gratian/hobby/kicad/bbb_alien_harness/bbb_alien_harness.kicad_pcb

## KiCad design kicad/bbb_alien_harness/bbb_alien_harness.kicad_pcb (2019-04-03)

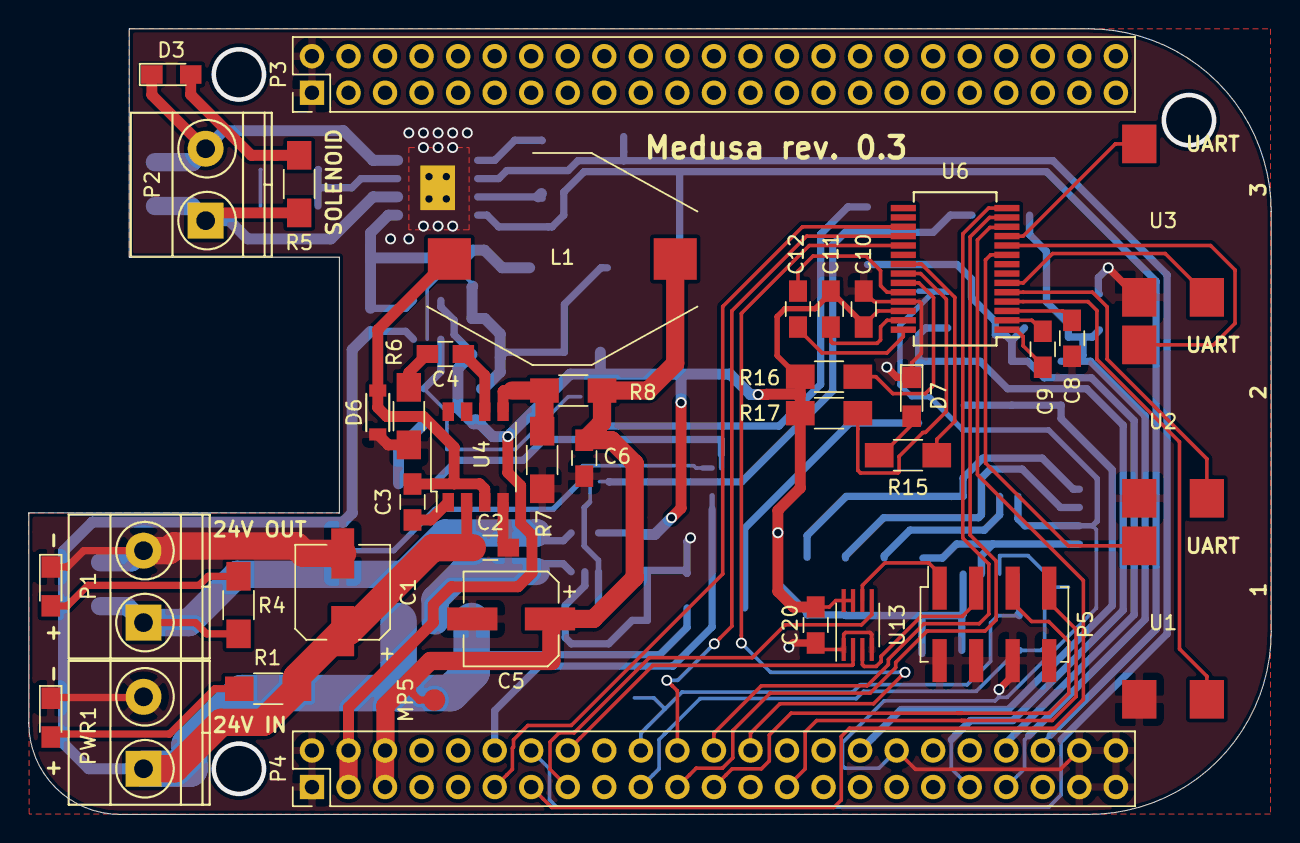
[picture p1: board bbb_alien_harness.kicad_pcb from above]

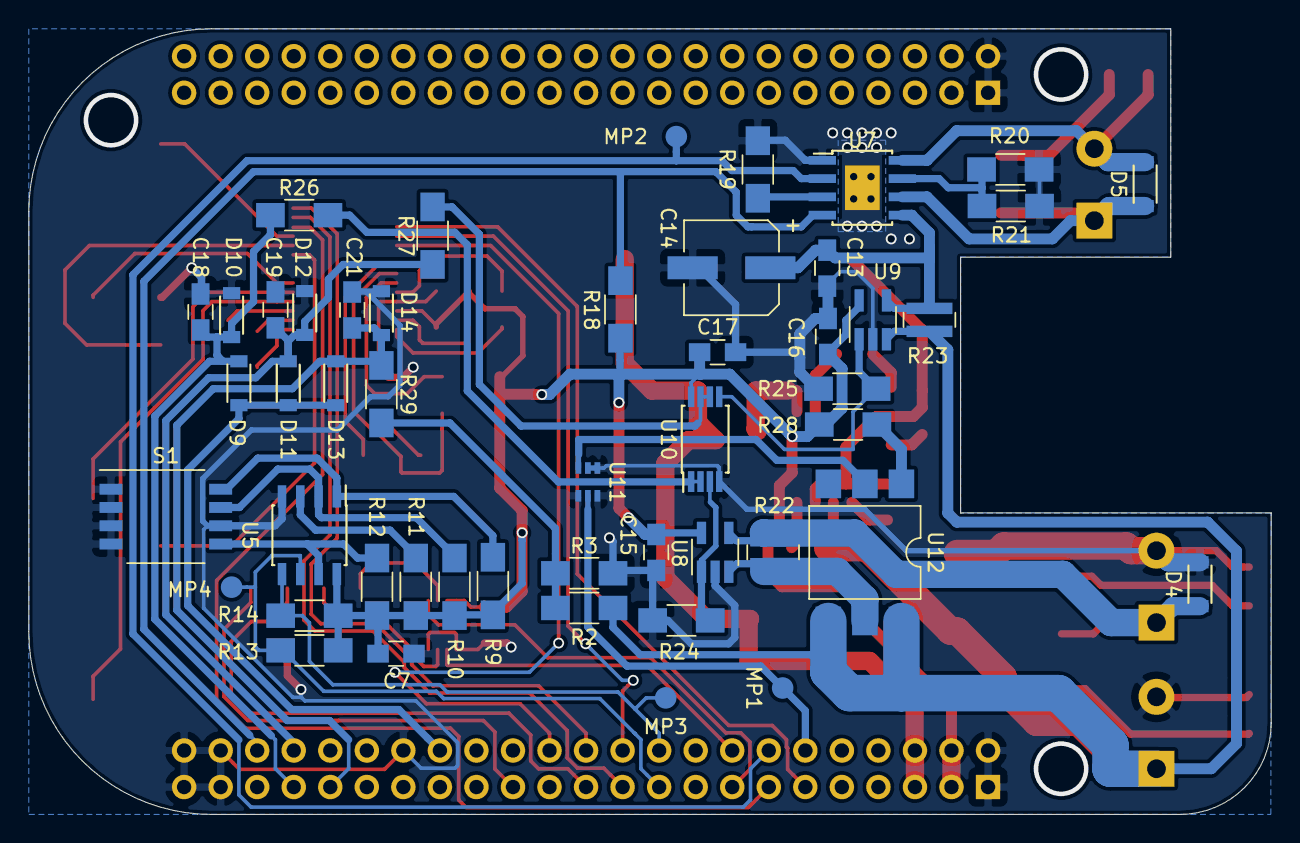
[picture p2: board bbb_alien_harness.kicad_pcb from below]

Board: 2 copper layers, 86.4 x 54.6 mm, 89 parts (49 on the bottom side), 67 nets.

Parts:
C1, C14: 47uF; CP_Elec_6.3x5.8
C2: 10uF; C_0805_HandSoldering
C3: 10nF; C_0805_HandSoldering
C4: 2.2nF; C_0805_HandSoldering
C5: 100uF; CP_Elec_6.3x5.8
C6: 1uF; C_0805_HandSoldering
C7, C8, C9, C10, C11, C12, C13, C15, C16, C17, C20: 0.1uF; C_0805_HandSoldering
C18, C19, C21: 1nF; C_0805_HandSoldering
D1: LXT0805YW; LED_0805_HandSoldering
D2, D7: LXT0805GW; LED_0805_HandSoldering
D3: D_1112H; LED_0805_HandSoldering
D4, D5, D6, D9, D10, D11, D12, D13, D14: DB2W40300L; SMD-Mini2-F3-B
L1: 33uH; L_Bourns-PM5022-330M-RC
MP1: SSR EN; Measurement_Point_Round-SMD-Pad_Small
MP2: PWM; Measurement_Point_Round-SMD-Pad_Small
MP3: I2C SDA; Measurement_Point_Round-SMD-Pad_Small
MP4: I2C SCL; Measurement_Point_Round-SMD-Pad_Small
MP5: +5V; Measurement_Point_Round-SMD-Pad_Small
P1: 24V OUT; TerminalBlock_Phoenix_MKDS1.5-2pol
P2: SOLENOID; TerminalBlock_Phoenix_MKDS1.5-2pol
P3: P8 on BBB; Pin_Header_Straight_2x23_Pitch2.54mm
P4: P9 on BBB; Pin_Header_Straight_2x23_Pitch2.54mm
P5: CONN_02X04; Socket_Strip_Straight_2x04_Pitch2.54mm_SMD
PWR1: 24V IN; TerminalBlock_Phoenix_MKDS1.5-2pol
R1, R4, R5: 2.4k; R_1206_HandSoldering
R2: 150k; R_1206_HandSoldering
R3, R7, R12, R16, R17, R18: 10k; R_1206_HandSoldering
R6: 8.2k; R_1206_HandSoldering
R8: 52k; R_1206_HandSoldering
R9, R10, R11: 4.7k; R_1206_HandSoldering
R13, R14: 5.6k; R_1206_HandSoldering
R15: 1k; R_1206_HandSoldering
R19: 100k; R_1206_HandSoldering
R20: 1; R_1206_HandSoldering
R21: 2; R_1206_HandSoldering
R22, R23: 0.020; R_0612
R24, R25: 75k; R_1206_HandSoldering
R26, R27, R29: 75; R_1206_HandSoldering
R28: 360; R_1206_HandSoldering
S1: SW_DIP_x4; SW_DIP_x4_W7.62mm_Slide_Copal_CHS-B
U1, U2, U3: SERIAL; SJ1-251X-SMT 2.5mm stereo jack
U4: ACT4065A; SOP-8_4.4x5mm_Pitch1.27mm
U5: 24C256; SOIC-8_3.9x4.9mm_Pitch1.27mm
U6: MAX3243; SSOP-28_5.3x10.2mm_Pitch0.65mm
U7: DRV8872; TI_SO-PowerPAD-8
U8, U9: INA138; SOT-23-5_HandSoldering
U10: AD8542; TSSOP-8_4.4x3mm_Pitch0.65mm
U11: DMC56404; SMini6-F3-B
U12: AQV251A; SMDIP-6_W9.53mm
U13: SN74LVC2G241; SSOP-8_2.95x2.8mm_Pitch0.65mm

Connections:
5V_REG: C5.1, C6.1, L1.2, MP5.1, P4.5, P4.6, R8.1
+3V3: C7.1, C10.2, C11.2, C15.1, C16.1, C17.1, C20.1, P4.3, P4.4, R9.1, R10.1, R11.1, R12.1, R13.1, R14.1, R16.1, R17.1, R18.1, R28.2, U5.8, U6.26, U8.5, U9.5, U10.8, U13.7, U13.8
+24V: C1.1, C2.1, PWR1.1, R1.1, R2.1, R23.1, U4.2, U9.3, U12.4, U12.6
/24V SSR/24V_OUT: R22.2, U8.3, U12.5
/POWER SENSE/OUT1: D4.1, P1.1, R4.1, R22.1, U8.4
/POWER SENSE/OUT2: C13.1, C14.1, R23.2, U7.5, U9.4
/POWER SENSE/sheet5AE7F055/IN: R26.2, U10.1, U10.2
/POWER SENSE/sheet5AE871AC/IN: R27.2, U10.6, U10.7
/SERIAL/RS232_RX1: U1.1, U6.4
/SERIAL/RS232_RX2: U2.1, U6.5
/SERIAL/RS232_RX3: U3.1, U6.6
/SERIAL/RS232_TX1: U1.2, U6.9
/SERIAL/RS232_TX2: U2.2, U6.10
/SERIAL/RS232_TX3: U3.2, U6.11
/SOLENOID DRIVER/S+: D5.1, P2.1, R5.1, U7.6
/SOLENOID DRIVER/S-: D3.1, D5.2, P2.2, U7.8
/sheet5B1360C9/IN: R2.2, R3.1, R29.2
AIN0: C18.1, D9.2, D10.1, P4.39, R26.1
AIN1: C19.1, D11.2, D12.1, P4.40, R27.1
AIN2: C21.1, D13.2, D14.1, P4.37, R29.1
EHRPWM1A: MP2.1, P4.14, U7.2
EHRPWM1B: P4.16, U13.2
GND: C1.2, C2.2, C5.2, C6.2, C7.2, C8.1, C10.1, C13.2, C14.2, C15.2, C16.2, C17.2, C18.2, C19.2, C20.2, C21.2, D1.1, D2.1, D4.2, D6.2, D7.1, D10.2, D12.2, D14.2, P1.2, P3.1, P3.2, P4.1, P4.2, P4.34, P4.43, P4.44, P4.45, P4.46, P5.2, P5.4, P5.6, P5.8, PWR1.2, R3.2, R6.2, R7.2, R19.2, R20.1, R21.1, R24.2, R25.2, S1.1, S1.2, S1.3, S1.4, S1.6, U1.3, U2.3, U3.3, U4.4, U5.4, U6.25, U7.1, U7.9, U8.2, U9.2, U10.4, U11.1, U11.3, U11.4, U11.5, U13.1, U13.4
GPIO0_7&GPIO3_18: P4.42, R18.2, U7.4
GPIO1_16: P4.15, U13.5
GPIO1_17: P4.23, P5.5
GPIO1_28: MP1.1, P4.12, U11.2
GPIO3_19: P4.27, P5.7
I2C2_SCL: MP4.1, P4.19, R13.2, U5.6
I2C2_SDA: MP3.1, P4.20, R14.2, U5.5
unnamed: C3.1, U4.1
unnamed: C3.2, D6.1, L1.1, U4.3
unnamed: C4.1, U4.6
unnamed: C4.2, R6.1
unnamed: C8.2, U6.3
unnamed: C9.1, U6.1
unnamed: C9.2, U6.2
unnamed: C11.1, U6.27
unnamed: C12.1, U6.28
unnamed: C12.2, U6.24
unnamed: D1.2, R1.2
unnamed: D2.2, R4.2
unnamed: D3.2, R5.2
unnamed: D7.2, R15.1
unnamed: P5.1, U13.6
unnamed: P5.3, U13.3
unnamed: R7.1, R8.2, U4.5
unnamed: R9.2, S1.8, U5.1
unnamed: R10.2, S1.7, U5.2
unnamed: R11.2, U5.3
unnamed: R12.2, S1.5, U5.7
unnamed: R15.2, U6.21
unnamed: R16.2, U6.23
unnamed: R17.2, U6.22
unnamed: R19.1, U7.3
unnamed: R20.2, R21.2, U7.7
unnamed: R24.1, U8.1, U10.3
unnamed: R25.1, U9.1, U10.5
unnamed: R28.1, U12.1
unnamed: U11.6, U12.2
UART1_RXD: P4.26, U6.19
UART1_TXD: P4.24, U6.14
UART2_RXD: P4.22, U6.18
UART2_TXD: P4.21, U6.13
UART4_RXD: P4.11, U6.17
UART4_TXD: P4.13, U6.12
VADC: D9.1, D11.1, D13.1, P4.32
