gratian/hobby/kicad/stepper_driver_with_protection/stepper_driver.kicad_pcb

## KiCad design kicad/stepper_driver_with_protection/stepper_driver.kicad_pcb (2018-04-12)

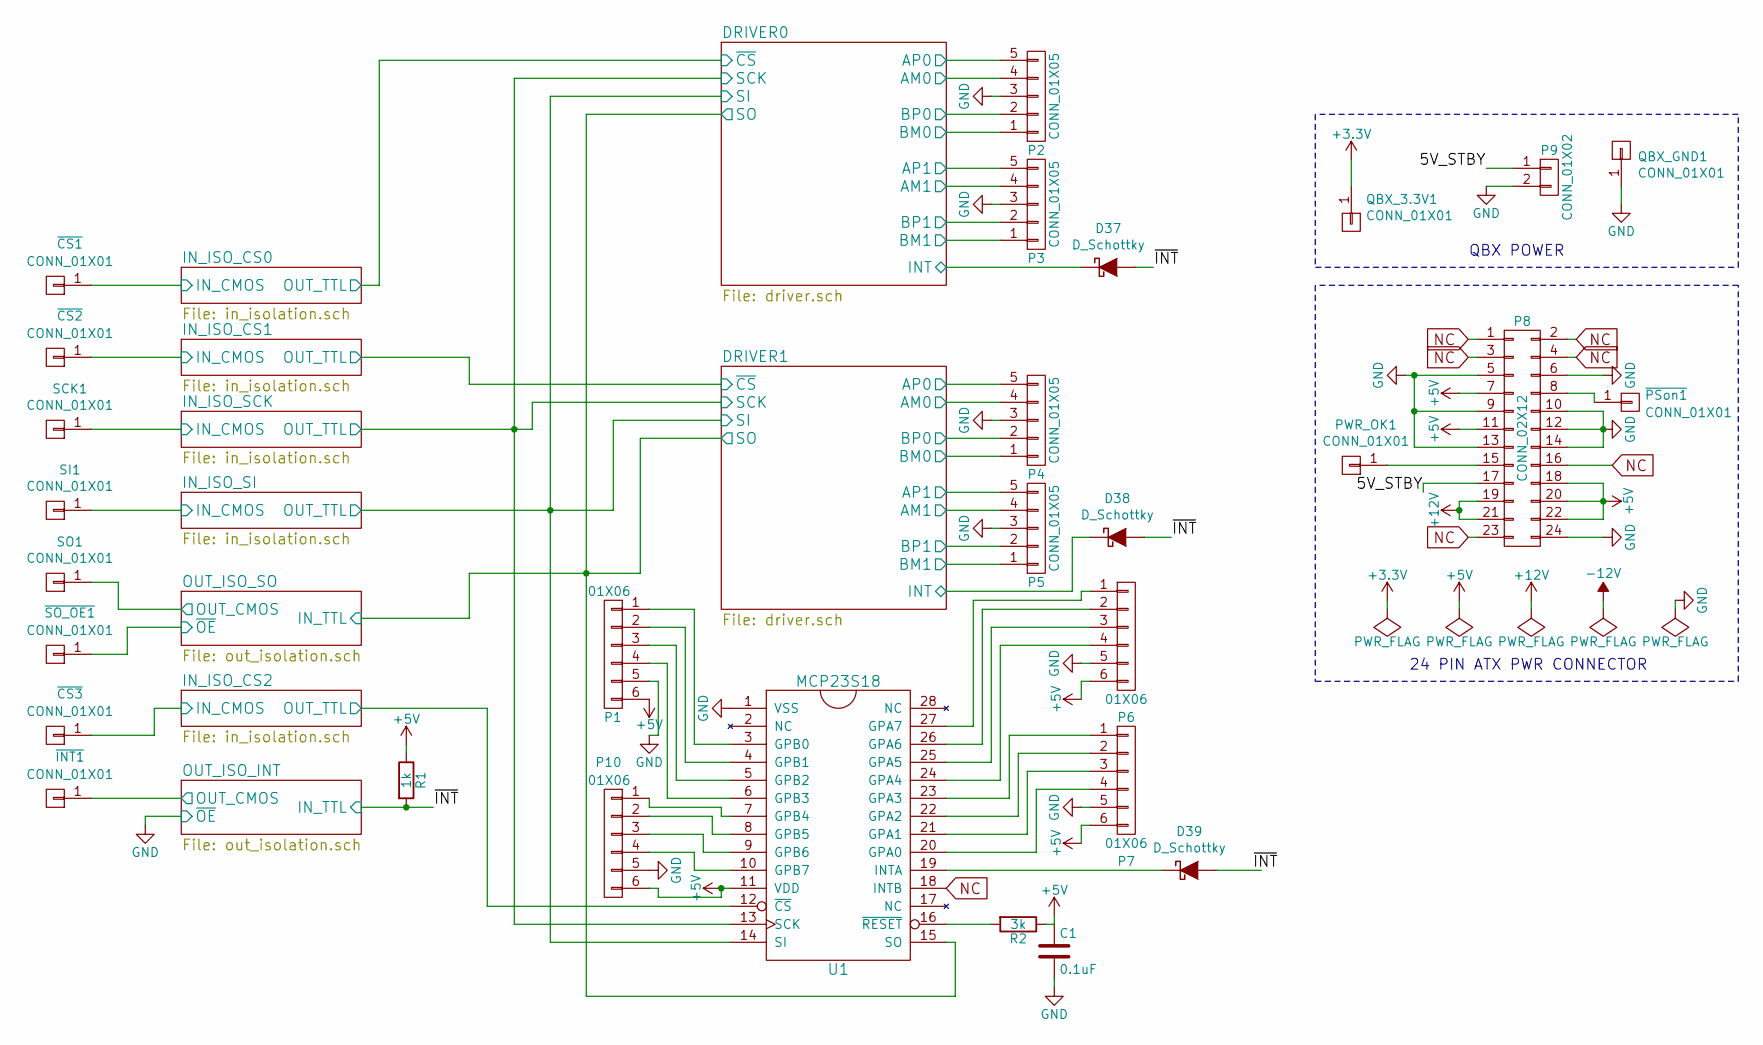
[picture p3: schematic stepper_driver.sch, Quad Stepper Motor Driver]

Parts:
C1: 0.1uF; C_1206_HandSoldering
D37, D38, D39: D_Schottky; Diode_DO-41_SOD81_Horizontal_RM10
P1, P6, P7, P10: 01X06; KF2EDGK-6_pin_Screw_Terminal_Block
P2, P3, P4, P5: CONN_01X05; TerminalBlock_Pheonix_PT-3.5mm_5pol
P8: CONN_02X12; Molex_MiniFit-JR-5556-24A_2x12x4.20mm_Straight
P9: CONN_01X02; PINHEAD1-2
PWR_OK1: CONN_01X01; SolderWirePad_single_0-8mmDrill
QBX_3.3V1: CONN_01X01; SolderWirePad_single_0-8mmDrill
QBX_GND1: CONN_01X01; SolderWirePad_single_0-8mmDrill
R1: 1k; R_1206_HandSoldering
R2: 3k; R_1206_HandSoldering
SCK1: CONN_01X01; SolderWirePad_single_0-8mmDrill
SI1: CONN_01X01; SolderWirePad_single_0-8mmDrill
SO1: CONN_01X01; SolderWirePad_single_0-8mmDrill
U1: MCP23S18; SOIC-28
~CS1, ~CS2, ~CS3: CONN_01X01; SolderWirePad_single_0-8mmDrill
~INT1: CONN_01X01; SolderWirePad_single_0-8mmDrill
~PSon1: CONN_01X01; SolderWirePad_single_0-8mmDrill
~SO_OE1: CONN_01X01; SolderWirePad_single_0-8mmDrill

Connections:
+3V3: QBX_3.3V1.1; also elsewhere on the board
+5V: C1.1, P1.6, P6.6, P7.6, P8.7, P8.11, P8.18, P8.20, P8.22, P10.6, R1.1, R2.1, U1.11 (VDD); also elsewhere on the board
+12V: P8.19, P8.21; also elsewhere on the board
/5V_STBY: P8.17, P9.1
/DRIVER0/AM0: P2.4; also elsewhere on the board
/DRIVER0/AM1: P3.4; also elsewhere on the board
/DRIVER0/AP0: P2.5; also elsewhere on the board
/DRIVER0/AP1: P3.5; also elsewhere on the board
/DRIVER0/BM0: P2.1; also elsewhere on the board
/DRIVER0/BM1: P3.1; also elsewhere on the board
/DRIVER0/BP0: P2.2; also elsewhere on the board
/DRIVER0/BP1: P3.2; also elsewhere on the board
/DRIVER0/INT: D37.1 (K); also elsewhere on the board
/DRIVER1/AM0: P4.4; also elsewhere on the board
/DRIVER1/AM1: P5.4; also elsewhere on the board
/DRIVER1/AP0: P4.5; also elsewhere on the board
/DRIVER1/AP1: P5.5; also elsewhere on the board
/DRIVER1/BM0: P4.1; also elsewhere on the board
/DRIVER1/BM1: P5.1; also elsewhere on the board
/DRIVER1/BP0: P4.2; also elsewhere on the board
/DRIVER1/BP1: P5.2; also elsewhere on the board
/DRIVER1/INT: D38.1 (K); also elsewhere on the board
/IN_ISO_CS2/OUT_TTL: U1.12 (~CS); also elsewhere on the board
/IN_ISO_SCK/IN_CMOS: SCK1.1; also elsewhere on the board
/IN_ISO_SCK/OUT_TTL: U1.13 (SCK); also elsewhere on the board
/IN_ISO_SI/IN_CMOS: SI1.1; also elsewhere on the board
/IN_ISO_SI/OUT_TTL: U1.14 (SI); also elsewhere on the board
/OUT_ISO_SO/IN_TTL: U1.15 (SO); also elsewhere on the board
/OUT_ISO_SO/OUT_CMOS: SO1.1; also elsewhere on the board
/~INT: D37.2 (A), D38.2 (A), D39.2 (A), R1.2; also elsewhere on the board
GND: C1.2, P1.5, P2.3, P3.3, P4.3, P5.3, P6.5, P7.5, P8.5, P8.6, P8.9, P8.10, P8.12, P8.13, P8.14, P8.24, P9.2, P10.5, QBX_GND1.1, U1.1 (VSS); also elsewhere on the board
NC: P8.1, P8.2, P8.3, P8.4, P8.16, P8.23, U1.18 (INTB); also elsewhere on the board
unnamed: D39.1 (K), U1.19 (INTA)
unnamed: P1.1, U1.3 (GPB0)
unnamed: P1.2, U1.4 (GPB1)
unnamed: P1.3, U1.5 (GPB2)
unnamed: P1.4, U1.6 (GPB3)
unnamed: P6.1, U1.27 (GPA7)
unnamed: P6.2, U1.26 (GPA6)
unnamed: P6.3, U1.25 (GPA5)
unnamed: P6.4, U1.24 (GPA4)
unnamed: P7.1, U1.23 (GPA3)
unnamed: P7.2, U1.22 (GPA2)
unnamed: P7.3, U1.21 (GPA1)
unnamed: P7.4, U1.20 (GPA0)
unnamed: P8.8, ~PSon1.1
unnamed: P8.15, PWR_OK1.1
unnamed: P10.1, U1.7 (GPB4)
unnamed: P10.2, U1.8 (GPB5)
unnamed: P10.3, U1.9 (GPB6)
unnamed: P10.4, U1.10 (GPB7)
unnamed: R2.2, U1.16 (~RESET)

Notes on the sheet:
24 PIN ATX PWR CONNECTOR
QBX POWER

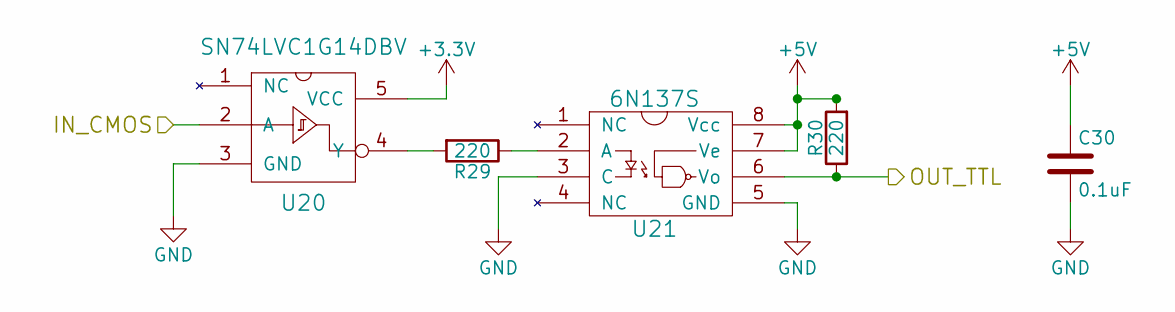
[picture p4: schematic in_isolation.sch, Quad Stepper Motor Driver]

Parts:
C2: 0.1uF; C_1206_HandSoldering
R3, R4: 220; R_1206_HandSoldering
U2: SN74LVC1G14DBV; SOT-23-5
U3: 6N137S; SMD-8

Connections:
+3V3: U2.5 (VCC); also elsewhere on the board
+5V: C2.1, R4.2, U3.7 (Ve), U3.8 (Vcc); also elsewhere on the board
/IN_ISO_CS0/IN_CMOS: U2.2 (A)
/IN_ISO_CS0/OUT_TTL: R4.1, U3.6 (Vo); also elsewhere on the board
GND: C2.2, U2.3 (GND), U3.3 (C), U3.5 (GND); also elsewhere on the board
unnamed: R3.1, U3.2 (A)
unnamed: R3.2, U2.4 (Y)

Parts of its further copies:
C3, C5, C6, C30: 0.1uF; C_1206_HandSoldering
R5, R6, R9, R10, R11, R12, R29, R30: 220; R_1206_HandSoldering
U4, U8, U10, U20: SN74LVC1G14DBV; SOT-23-5
U5, U9, U11, U21: 6N137S; SMD-8

Connections of its further copies:
+3V3: U4.5 (VCC), U8.5 (VCC), U10.5 (VCC), U20.5 (VCC); also elsewhere on the board
+5V: C3.1, C5.1, C6.1, C30.1, R6.2, R10.2, R12.2, R30.2, U5.7 (Ve), U5.8 (Vcc), U9.7 (Ve), U9.8 (Vcc), U11.7 (Ve), U11.8 (Vcc), U21.7 (Ve), U21.8 (Vcc); also elsewhere on the board
/IN_ISO_CS1/IN_CMOS: U10.2 (A)
/IN_ISO_CS1/OUT_TTL: R12.1, U11.6 (Vo); also elsewhere on the board
/IN_ISO_CS2/IN_CMOS: U20.2 (A)
/IN_ISO_CS2/OUT_TTL: R30.1, U21.6 (Vo); also elsewhere on the board
/IN_ISO_SCK/IN_CMOS: U4.2 (A); also elsewhere on the board
/IN_ISO_SCK/OUT_TTL: R6.1, U5.6 (Vo); also elsewhere on the board
/IN_ISO_SI/IN_CMOS: U8.2 (A); also elsewhere on the board
/IN_ISO_SI/OUT_TTL: R10.1, U9.6 (Vo); also elsewhere on the board
GND: C3.2, C5.2, C6.2, C30.2, U4.3 (GND), U5.3 (C), U5.5 (GND), U8.3 (GND), U9.3 (C), U9.5 (GND), U10.3 (GND), U11.3 (C), U11.5 (GND), U20.3 (GND), U21.3 (C), U21.5 (GND); also elsewhere on the board
unnamed: R5.1, U5.2 (A)
unnamed: R5.2, U4.4 (Y)
unnamed: R9.1, U9.2 (A)
unnamed: R9.2, U8.4 (Y)
unnamed: R11.1, U11.2 (A)
unnamed: R11.2, U10.4 (Y)
unnamed: R29.1, U21.2 (A)
unnamed: R29.2, U20.4 (Y)

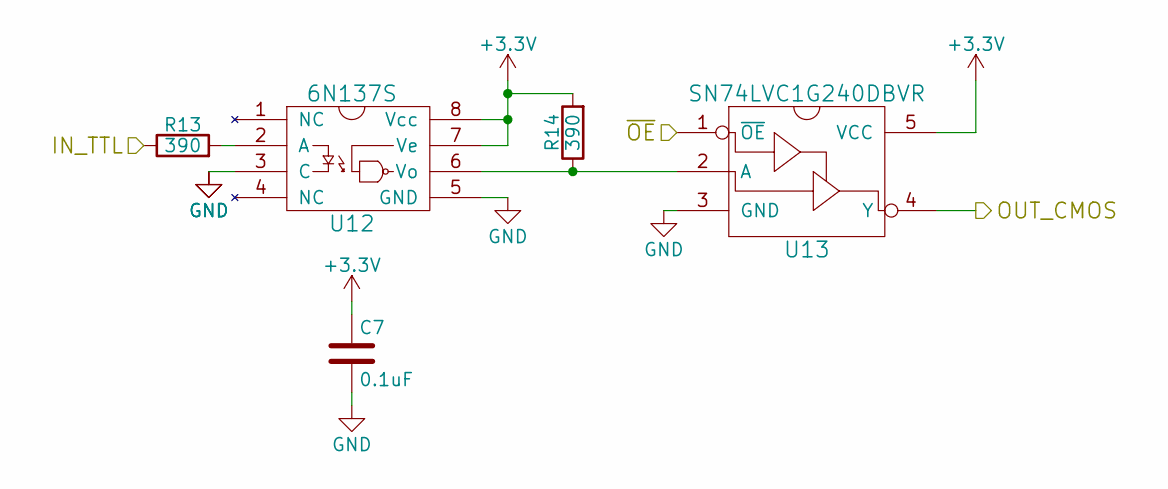
[picture p5: schematic out_isolation.sch, Quad Stepper Motor Driver]

Parts:
C4: 0.1uF; C_1206_HandSoldering
R7, R8: 390; R_1206_HandSoldering
U6: 6N137S; SMD-8
U7: SN74LVC1G240DBVR; SOT-23-5

Connections:
+3V3: C4.1, R8.2, U6.7 (Ve), U6.8 (Vcc), U7.5 (VCC); also elsewhere on the board
/OUT_ISO_SO/IN_TTL: R7.1; also elsewhere on the board
/OUT_ISO_SO/OUT_CMOS: U7.4 (Y); also elsewhere on the board
/OUT_ISO_SO/~OE: U7.1 (~OE)
GND: C4.2, U6.3 (C), U6.5 (GND), U7.3 (GND); also elsewhere on the board
unnamed: R7.2, U6.2 (A)
unnamed: R8.1, U6.6 (Vo), U7.2 (A)

Parts of its further copies:
C7: 0.1uF; C_1206_HandSoldering
R13, R14: 390; R_1206_HandSoldering
U12: 6N137S; SMD-8
U13: SN74LVC1G240DBVR; SOT-23-5

Connections of its further copies:
+3V3: C7.1, R14.2, U12.7 (Ve), U12.8 (Vcc), U13.5 (VCC); also elsewhere on the board
/OUT_ISO_INT/OUT_CMOS: U13.4 (Y)
/~INT: R13.1; also elsewhere on the board
GND: C7.2, U12.3 (C), U12.5 (GND), U13.1 (~OE), U13.3 (GND); also elsewhere on the board
unnamed: R13.2, U12.2 (A)
unnamed: R14.1, U12.6 (Vo), U13.2 (A)

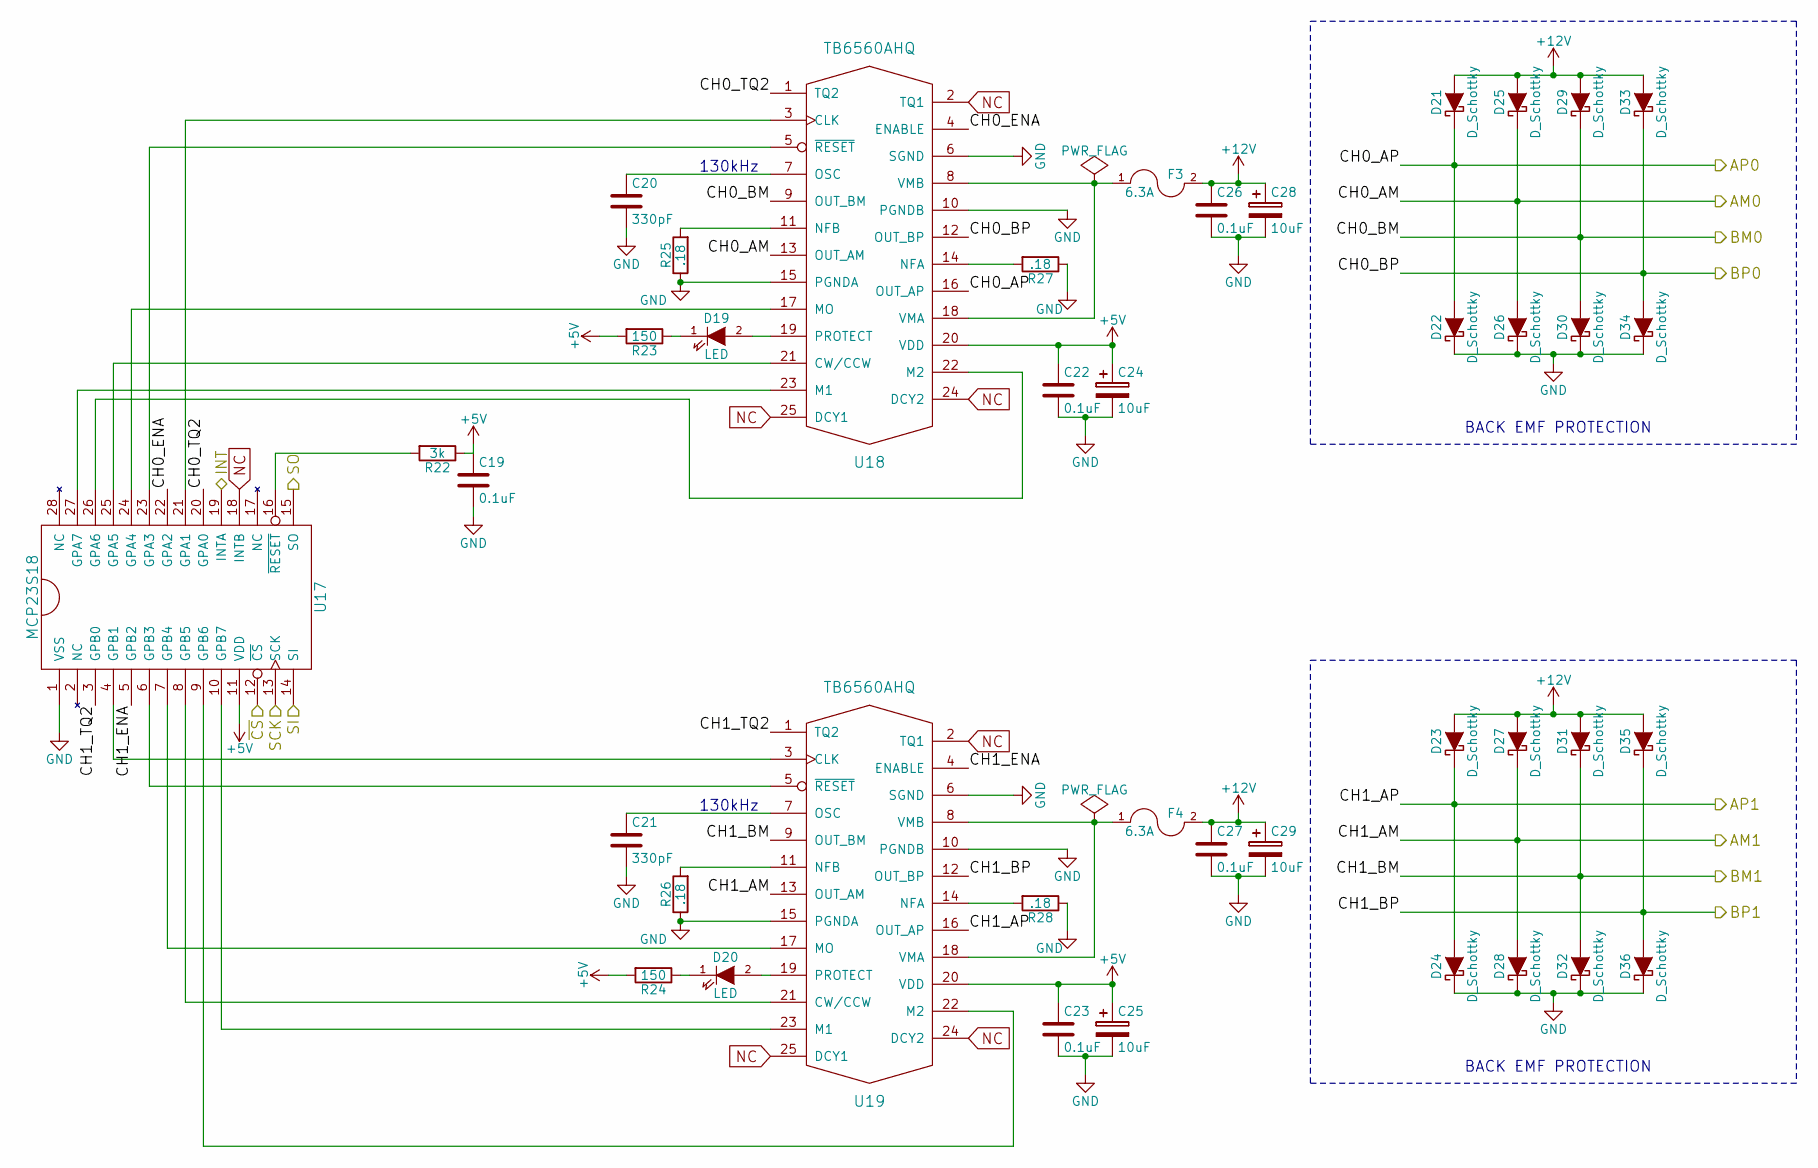
[picture p6: schematic driver.sch, Quad Stepper Motor Driver]

Parts:
C8, C11, C12, C15, C16: 0.1uF; C_1206_HandSoldering
C9, C10: 330pF; C_0805_HandSoldering
C13, C14, C17, C18: 10uF; c_elec_4x5.3
D1, D2: LED; LED-3MM
D3, D4, D5, D6, D7, D8, D9, D10, D11, D12, D13, D14, D15, D16, D17, D18: D_Schottky; SMD-Mini2-F3-B
F1, F2: 6.3A; Fuse_SMD2410
R15: 3k; R_1206_HandSoldering
R16, R17: 150; R_1206_HandSoldering
R18, R19, R20, R21: .18; R_1206_HandSoldering
U14: MCP23S18; SOIC-28
U15, U16: TB6560AHQ; HZIP25-P-1.27

Connections:
+5V: C8.1, C11.1, C12.1, C13.1, C14.1, R15.1, R16.2, R17.2, U14.11 (VDD), U15.20 (VDD), U16.20 (VDD); also elsewhere on the board
+12V: C15.1, C16.1, C17.1, C18.1, D3.2 (A), D5.2 (A), D7.2 (A), D9.2 (A), D11.2 (A), D13.2 (A), D15.2 (A), D17.2 (A), F1.2, F2.2; also elsewhere on the board
/DRIVER0/AM0: D7.1 (K), D8.2 (A), U15.13 (OUT_AM); also elsewhere on the board
/DRIVER0/AM1: D9.1 (K), D10.2 (A), U16.13 (OUT_AM); also elsewhere on the board
/DRIVER0/AP0: D3.1 (K), D4.2 (A), U15.16 (OUT_AP); also elsewhere on the board
/DRIVER0/AP1: D5.1 (K), D6.2 (A), U16.16 (OUT_AP); also elsewhere on the board
/DRIVER0/BM0: D11.1 (K), D12.2 (A), U15.9 (OUT_BM); also elsewhere on the board
/DRIVER0/BM1: D13.1 (K), D14.2 (A), U16.9 (OUT_BM); also elsewhere on the board
/DRIVER0/BP0: D15.1 (K), D16.2 (A), U15.12 (OUT_BP); also elsewhere on the board
/DRIVER0/BP1: D17.1 (K), D18.2 (A), U16.12 (OUT_BP); also elsewhere on the board
/DRIVER0/CH0_ENA: U14.22 (GPA2), U15.4 (ENABLE)
/DRIVER0/CH0_TQ2: U14.20 (GPA0), U15.1 (TQ2)
/DRIVER0/CH1_ENA: U14.5 (GPB2), U16.4 (ENABLE)
/DRIVER0/CH1_TQ2: U14.3 (GPB0), U16.1 (TQ2)
/DRIVER0/INT: U14.19 (INTA); also elsewhere on the board
/IN_ISO_CS0/OUT_TTL: U14.12 (~CS); also elsewhere on the board
/IN_ISO_SCK/OUT_TTL: U14.13 (SCK); also elsewhere on the board
/IN_ISO_SI/OUT_TTL: U14.14 (SI); also elsewhere on the board
/OUT_ISO_SO/IN_TTL: U14.15 (SO); also elsewhere on the board
GND: C8.2, C9.2, C10.2, C11.2, C12.2, C13.2, C14.2, C15.2, C16.2, C17.2, C18.2, D4.1 (K), D6.1 (K), D8.1 (K), D10.1 (K), D12.1 (K), D14.1 (K), D16.1 (K), D18.1 (K), R18.1, R19.1, R20.1, R21.1, U14.1 (VSS), U15.6 (SGND), U15.10 (PGNDB), U15.15 (PGNDA), U16.6 (SGND), U16.10 (PGNDB), U16.15 (PGNDA); also elsewhere on the board
NC: U14.18 (INTB), U15.2 (TQ1), U15.24 (DCY2), U15.25 (DCY1), U16.2 (TQ1), U16.24 (DCY2), U16.25 (DCY1); also elsewhere on the board
unnamed: C9.1, U15.7 (OSC)
unnamed: C10.1, U16.7 (OSC)
unnamed: D1.1 (K), R16.1
unnamed: D1.2 (A), U15.19 (PROTECT)
unnamed: D2.1 (K), R17.1
unnamed: D2.2 (A), U16.19 (PROTECT)
unnamed: F1.1, U15.8 (VMB), U15.18 (VMA)
unnamed: F2.1, U16.8 (VMB), U16.18 (VMA)
unnamed: R15.2, U14.16 (~RESET)
unnamed: R18.2, U15.11 (NFB)
unnamed: R19.2, U16.11 (NFB)
unnamed: R20.2, U15.14 (NFA)
unnamed: R21.2, U16.14 (NFA)
unnamed: U14.4 (GPB1), U16.3 (CLK)
unnamed: U14.6 (GPB3), U16.5 (~RESET)
unnamed: U14.7 (GPB4), U16.17 (MO)
unnamed: U14.8 (GPB5), U16.21 (CW/CCW)
unnamed: U14.9 (GPB6), U16.22 (M2)
unnamed: U14.10 (GPB7), U16.23 (M1)
unnamed: U14.21 (GPA1), U15.3 (CLK)
unnamed: U14.23 (GPA3), U15.5 (~RESET)
unnamed: U14.24 (GPA4), U15.17 (MO)
unnamed: U14.25 (GPA5), U15.21 (CW/CCW)
unnamed: U14.26 (GPA6), U15.22 (M2)
unnamed: U14.27 (GPA7), U15.23 (M1)

Parts of its further copies:
C19, C22, C23, C26, C27: 0.1uF; C_1206_HandSoldering
C20, C21: 330pF; C_0805_HandSoldering
C24, C25, C28, C29: 10uF; c_elec_4x5.3
D19, D20: LED; LED-3MM
D21, D22, D23, D24, D25, D26, D27, D28, D29, D30, D31, D32, D33, D34, D35, D36: D_Schottky; SMD-Mini2-F3-B
F3, F4: 6.3A; Fuse_SMD2410
R22: 3k; R_1206_HandSoldering
R23, R24: 150; R_1206_HandSoldering
R25, R26, R27, R28: .18; R_1206_HandSoldering
U17: MCP23S18; SOIC-28
U18, U19: TB6560AHQ; HZIP25-P-1.27

Connections of its further copies:
+5V: C19.1, C22.1, C23.1, C24.1, C25.1, R22.1, R23.2, R24.2, U17.11 (VDD), U18.20 (VDD), U19.20 (VDD); also elsewhere on the board
+12V: C26.1, C27.1, C28.1, C29.1, D21.2 (A), D23.2 (A), D25.2 (A), D27.2 (A), D29.2 (A), D31.2 (A), D33.2 (A), D35.2 (A), F3.2, F4.2; also elsewhere on the board
/DRIVER1/AM0: D25.1 (K), D26.2 (A), U18.13 (OUT_AM); also elsewhere on the board
/DRIVER1/AM1: D27.1 (K), D28.2 (A), U19.13 (OUT_AM); also elsewhere on the board
/DRIVER1/AP0: D21.1 (K), D22.2 (A), U18.16 (OUT_AP); also elsewhere on the board
/DRIVER1/AP1: D23.1 (K), D24.2 (A), U19.16 (OUT_AP); also elsewhere on the board
/DRIVER1/BM0: D29.1 (K), D30.2 (A), U18.9 (OUT_BM); also elsewhere on the board
/DRIVER1/BM1: D31.1 (K), D32.2 (A), U19.9 (OUT_BM); also elsewhere on the board
/DRIVER1/BP0: D33.1 (K), D34.2 (A), U18.12 (OUT_BP); also elsewhere on the board
/DRIVER1/BP1: D35.1 (K), D36.2 (A), U19.12 (OUT_BP); also elsewhere on the board
/DRIVER1/CH0_ENA: U17.22 (GPA2), U18.4 (ENABLE)
/DRIVER1/CH0_TQ2: U17.20 (GPA0), U18.1 (TQ2)
/DRIVER1/CH1_ENA: U17.5 (GPB2), U19.4 (ENABLE)
/DRIVER1/CH1_TQ2: U17.3 (GPB0), U19.1 (TQ2)
/DRIVER1/INT: U17.19 (INTA); also elsewhere on the board
/IN_ISO_CS1/OUT_TTL: U17.12 (~CS); also elsewhere on the board
/IN_ISO_SCK/OUT_TTL: U17.13 (SCK); also elsewhere on the board
/IN_ISO_SI/OUT_TTL: U17.14 (SI); also elsewhere on the board
/OUT_ISO_SO/IN_TTL: U17.15 (SO); also elsewhere on the board
GND: C19.2, C20.2, C21.2, C22.2, C23.2, C24.2, C25.2, C26.2, C27.2, C28.2, C29.2, D22.1 (K), D24.1 (K), D26.1 (K), D28.1 (K), D30.1 (K), D32.1 (K), D34.1 (K), D36.1 (K), R25.1, R26.1, R27.1, R28.1, U17.1 (VSS), U18.6 (SGND), U18.10 (PGNDB), U18.15 (PGNDA), U19.6 (SGND), U19.10 (PGNDB), U19.15 (PGNDA); also elsewhere on the board
NC: U17.18 (INTB), U18.2 (TQ1), U18.24 (DCY2), U18.25 (DCY1), U19.2 (TQ1), U19.24 (DCY2), U19.25 (DCY1); also elsewhere on the board
unnamed: C20.1, U18.7 (OSC)
unnamed: C21.1, U19.7 (OSC)
unnamed: D19.1 (K), R23.1
unnamed: D19.2 (A), U18.19 (PROTECT)
unnamed: D20.1 (K), R24.1
unnamed: D20.2 (A), U19.19 (PROTECT)
unnamed: F3.1, U18.8 (VMB), U18.18 (VMA)
unnamed: F4.1, U19.8 (VMB), U19.18 (VMA)
unnamed: R22.2, U17.16 (~RESET)
unnamed: R25.2, U18.11 (NFB)
unnamed: R26.2, U19.11 (NFB)
unnamed: R27.2, U18.14 (NFA)
unnamed: R28.2, U19.14 (NFA)
unnamed: U17.4 (GPB1), U19.3 (CLK)
unnamed: U17.6 (GPB3), U19.5 (~RESET)
unnamed: U17.7 (GPB4), U19.17 (MO)
unnamed: U17.8 (GPB5), U19.21 (CW/CCW)
unnamed: U17.9 (GPB6), U19.22 (M2)
unnamed: U17.10 (GPB7), U19.23 (M1)
unnamed: U17.21 (GPA1), U18.3 (CLK)
unnamed: U17.23 (GPA3), U18.5 (~RESET)
unnamed: U17.24 (GPA4), U18.17 (MO)
unnamed: U17.25 (GPA5), U18.21 (CW/CCW)
unnamed: U17.26 (GPA6), U18.22 (M2)
unnamed: U17.27 (GPA7), U18.23 (M1)

Notes on the sheet:
BACK EMF PROTECTION
130kHz

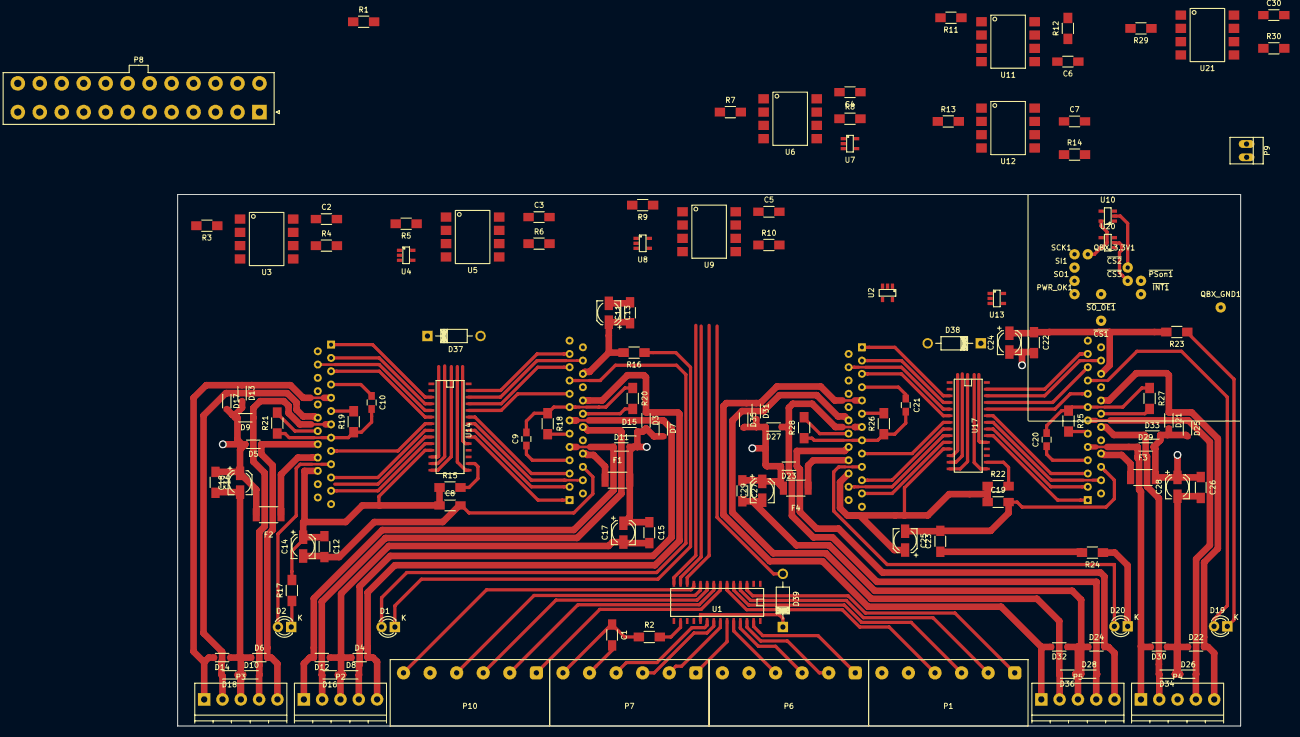
[picture p7: board stepper_driver.kicad_pcb from above]

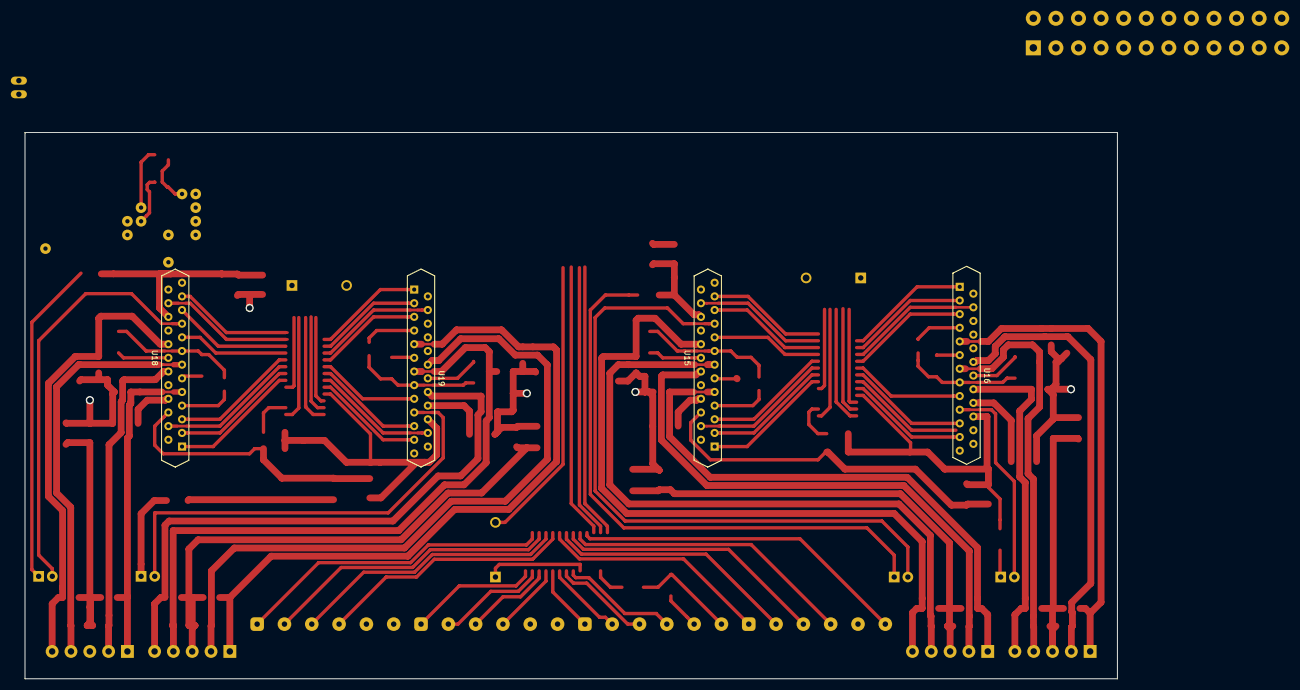
[picture p8: board stepper_driver.kicad_pcb from below]

Board: 2 copper layers, 203.2 x 101.6 mm, 140 parts (4 on the bottom side), 125 nets.
