gratian/hobby/(commit log)

2015-03-25 kicad: Add inital project for bipolar stepper driver
    [DIO.sch, driver.sch, in_isolation.sch, out_isolation.sch, stepper_driver.sch]
2015-03-25 kicad,library: Fix documentation paths
    [driver.sch, in_isolation.sch, out_isolation.sch, stepper_driver.sch]
2018-04-12 stepper_driver: new revision
    Forgot the history on this one. If anybody is watching. Sorry :(
    Moved datahseets into project folder.
    I guess I've added some footprints too.
    [driver.sch, in_isolation.sch, out_isolation.sch, stepper_driver.kicad_pcb, stepper_driver.sch]
2018-04-12 stepper_driver_with_protection: New design.
    [DIO.sch, driver.sch, in_isolation.sch, out_isolation.sch, stepper_driver.kicad_pcb, stepper_driver.sch]
2019-04-03 library: new updates from upstream kicad
2019-04-03 bbb_alien_harness: medusa prototype (ver. 0.3)
    This is the first manufactured prototype of the Medusa Beagle Bone
    Black cape ver 0.3.
    [24v_ssr.sch, 5v_step_down_converter.sch, 5v_step_down_regulator.sch, adc_clamp_filter.sch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]
